SartoriDynamics/Furuta-Pendulum/Furuta 3D printing files/Furuta - TampaCilindro.stl

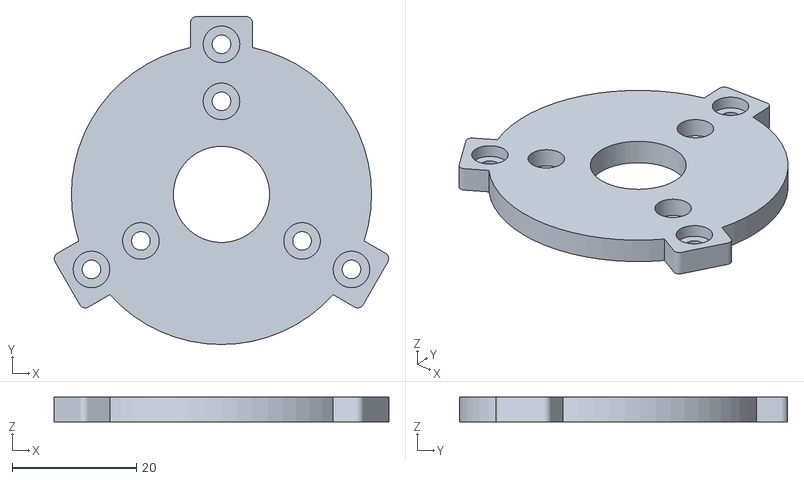
[picture p3: CAD file, 2026-05-11]
Furuta 3D printing files/Furuta - TampaCilindro.stl
53.9 x 52.9 x 4.00
