SartoriDynamics/Furuta-Pendulum/Furuta 3D printing files/Furuta - Haste.stl

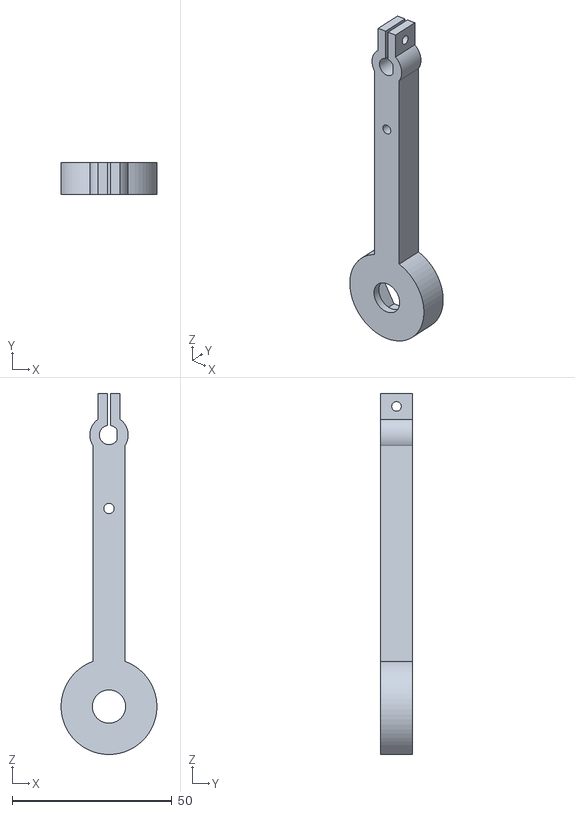
[picture p4: CAD file, 2026-05-11]
Furuta 3D printing files/Furuta - Haste.stl
30.0 x 10.0 x 113.0
