SartoriDynamics/Furuta-Pendulum/Furuta 3D printing files/Furuta - TampaBase.stl

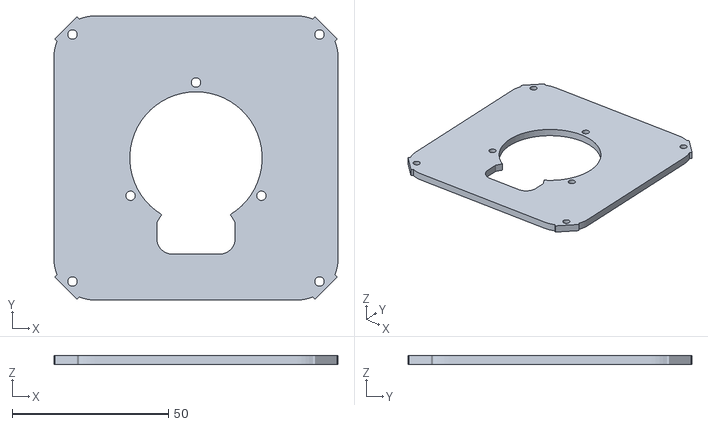
[picture p5: CAD file, 2026-05-11]
Furuta 3D printing files/Furuta - TampaBase.stl
91.0 x 91.0 x 3.00
