SartoriDynamics/Furuta-Pendulum/Furuta 3D printing files/Furuta - Base.stl

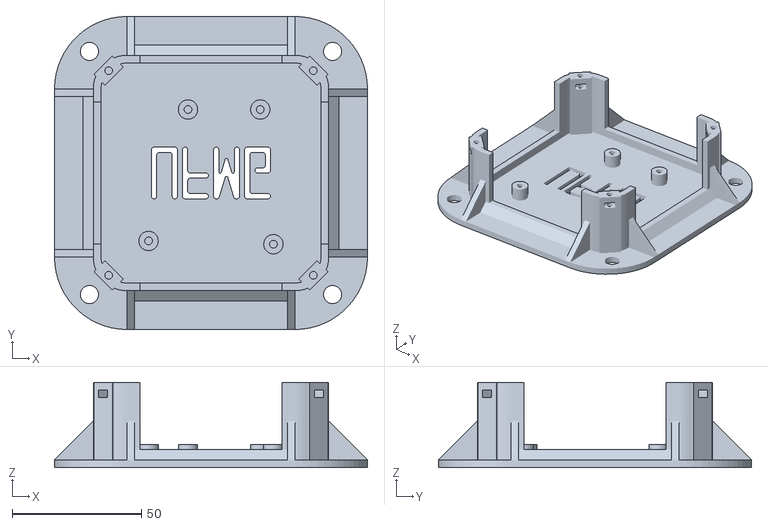
[picture p6: CAD file, 2026-05-11]
Furuta 3D printing files/Furuta - Base.stl
121.0 x 121.0 x 33.0
