SartoriDynamics/Furuta-Pendulum/Furuta 3D printing files/Furuta - BracoRotativo.stl

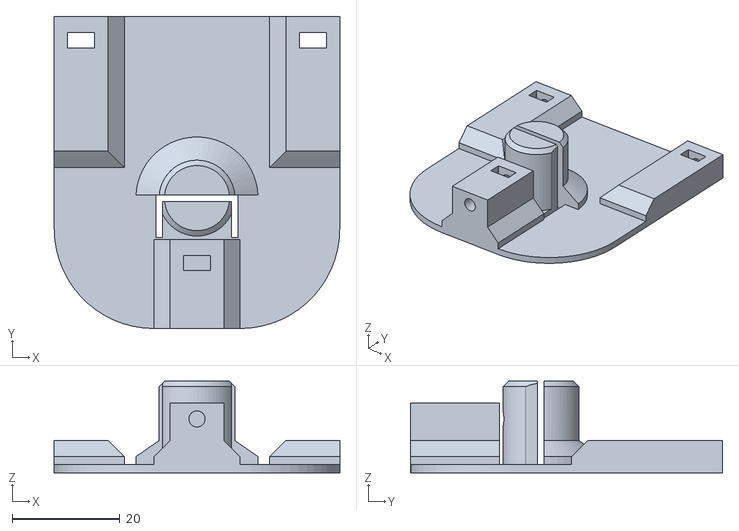
[picture p7: CAD file, 2026-05-11]
Furuta 3D printing files/Furuta - BracoRotativo.stl
53.0 x 57.9 x 17.0
