SartoriDynamics/Furuta-Pendulum/Furuta 3D printing files/Furuta - SuporteEncoder.stl

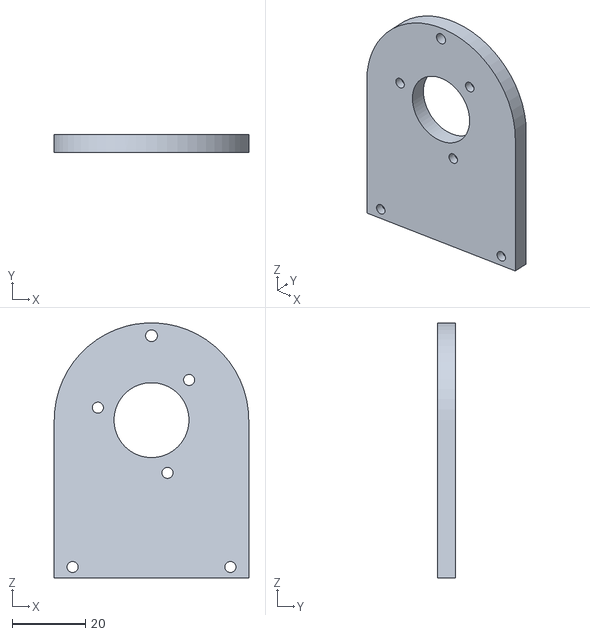
[picture p8: CAD file, 2026-05-11]
Furuta 3D printing files/Furuta - SuporteEncoder.stl
53.0 x 5.00 x 69.5
