SartoriDynamics/Furuta-Pendulum/Furuta 3D printing files/Furuta - Cilindro.stl

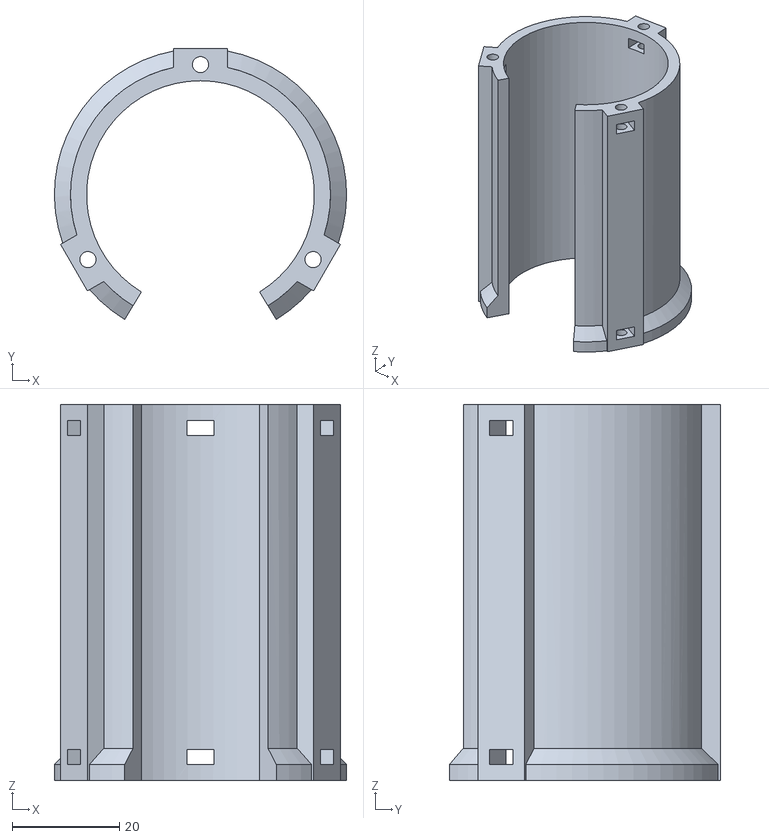
[picture p9: CAD file, 2026-05-11]
Furuta 3D printing files/Furuta - Cilindro.stl
54.4 x 50.5 x 70.0
