SartoriDynamics/Furuta-Pendulum/Python codes/DownwardStepData.txt

2.08 0.000000 0.000000 0.000000 0.000000 0.000000 0.00
2.08 0.000000 0.000000 0.000000 0.000000 0.000000 0.00
2.09 0.000000 0.000000 0.000000 0.000000 0.000000 0.00
2.09 0.000000 0.000000 0.000000 0.000000 0.000000 0.00
2.09 0.000000 0.000000 0.000000 0.000000 0.000000 0.00
2.10 0.000000 0.000000 0.000000 0.000000 0.000000 0.00
2.10 0.000000 0.000000 0.000000 0.000000 0.000000 0.00
2.10 0.000000 0.000000 0.000000 0.000000 0.000000 0.00
2.12 0.000000 0.000000 0.000000 0.000000 0.000000 0.00
2.12 0.000000 0.000000 0.000000 0.000000 0.000000 0.00
2.12 0.000000 0.000000 0.000000 0.000000 0.000000 0.00
2.13 0.000000 0.000000 0.000000 0.000000 0.000000 0.00
2.13 0.000000 0.000000 0.000000 0.000000 0.000000 0.00
2.14 0.000000 0.000000 0.000000 0.000000 0.000000 0.00
2.14 0.000000 0.000000 0.000000 0.000000 0.000000 0.00
2.14 0.000000 0.000000 0.000000 0.000000 0.000000 0.00
2.15 0.000000 0.000000 0.000000 0.000000 0.000000 0.00
2.16 0.000000 0.000000 0.000000 0.000000 0.000000 0.00
2.16 0.000000 0.000000 0.000000 0.000000 0.000000 0.00
2.17 0.000000 0.000000 0.000000 0.000000 0.000000 0.00
2.17 0.000000 0.000000 0.000000 0.000000 0.000000 0.00
2.17 0.000000 0.000000 0.000000 0.000000 0.000000 0.00
2.18 0.000000 0.000000 0.000000 0.000000 0.000000 0.00
2.18 0.000000 0.000000 0.000000 0.000000 0.000000 0.00
2.19 0.000000 0.000000 0.000000 0.000000 0.000000 0.00
2.20 0.000000 0.000000 0.000000 0.000000 0.000000 0.00
2.20 0.000000 0.000000 0.000000 0.000000 0.000000 0.00
2.21 0.000000 0.000000 0.000000 0.000000 0.000000 0.00
2.21 0.000000 0.000000 0.000000 0.000000 0.000000 0.00
2.21 0.000000 0.000000 0.000000 0.000000 0.000000 0.00
2.22 0.000000 0.000000 0.000000 0.000000 0.000000 0.00
2.22 0.000000 0.000000 0.000000 0.000000 0.000000 0.00
2.22 0.000000 0.000000 0.000000 0.000000 0.000000 0.00
2.24 0.000000 0.000000 0.000000 0.000000 0.000000 0.00
2.24 0.000000 0.000000 0.000000 0.000000 0.000000 0.00
2.25 0.000000 0.000000 0.000000 0.000000 0.000000 0.00
2.25 0.000000 0.000000 0.000000 0.000000 0.000000 0.00
2.25 0.000000 0.000000 0.000000 0.000000 0.000000 0.00
2.26 0.000000 0.000000 0.000000 0.000000 0.000000 0.00
2.26 0.000000 0.000000 0.000000 0.000000 0.000000 0.00
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
