SartoriDynamics/Furuta-Pendulum/Python codes/UprightStepData.txt

4.39 0.094126 -0.344985 -0.291586 -0.581114 6.529924 0.00
4.40 0.110186 -0.302272 3.719446 3.382309 1.817587 0.00
4.41 0.128388 -0.240370 2.929203 5.302689 -2.043520 0.00
4.42 0.114113 -0.184680 -1.176501 4.723073 -3.548555 0.00
4.43 0.079749 -0.144243 -4.357677 3.245106 -3.302943 0.00
4.44 0.044803 -0.118012 -5.173871 1.909844 -2.239218 0.00
4.45 0.012548 -0.100870 -4.737822 1.140456 -1.371387 0.00
4.46 -0.004162 -0.084291 -3.154929 1.035681 -1.002472 0.00
4.47 -0.018193 -0.063223 -2.348253 1.382408 -1.565581 0.00
4.48 -0.019045 -0.037417 -1.452251 1.661098 -2.080922 0.00
4.49 -0.018372 -0.011011 -1.306247 1.690366 -2.515808 0.00
4.50 -0.018272 0.003877 -1.482401 0.896615 -1.759669 0.00
4.51 -0.018174 0.016345 -1.190597 0.658768 -1.555241 0.00
4.52 -0.017770 0.021571 -0.989714 0.182934 -0.939711 0.00
4.53 -0.017297 0.025571 -0.653003 0.092846 -0.776166 0.00
4.54 -0.016836 0.029809 -0.483416 0.120040 -0.828286 0.00
4.55 -0.002588 0.030399 0.489285 -0.126426 -0.183168 0.00
4.56 0.000180 0.030336 0.264608 -0.074948 -0.322861 0.00
4.57 0.000198 0.026605 -0.049887 -0.316340 -0.039219 0.00
4.58 -0.000038 0.025829 -0.033328 -0.152140 -0.240940 0.00
4.59 0.013920 0.022105 0.854887 -0.347576 0.380548 0.00
4.60 0.016560 0.017745 0.604399 -0.286432 0.291634 0.00
4.61 0.016554 0.009680 0.309858 -0.517289 0.640453 0.00
4.62 0.030390 0.004545 1.325042 -0.358059 0.851725 0.00
4.63 0.033010 -0.003396 0.935585 -0.407011 0.925167 0.00
4.64 0.032906 -0.012067 0.666071 -0.455061 1.047325 0.00
4.65 0.032646 -0.017070 0.628066 -0.220667 0.804756 0.00
4.66 0.046523 -0.021297 1.476631 -0.172453 1.095238 0.00
4.67 0.048987 -0.021720 1.062138 0.170101 0.509522 0.00
4.68 0.048610 -0.021460 0.490110 0.192700 0.288186 0.00
4.69 0.047886 -0.017691 0.205904 0.363001 -0.096380 0.00
4.70 0.047383 -0.017035 -0.027957 0.136401 0.119739 0.00
4.71 0.047161 -0.017198 0.020567 0.056922 0.244683 0.00
4.72 0.047232 -0.017297 0.109585 0.062995 0.267267 0.00
4.73 0.047340 -0.017297 0.147468 0.077170 0.260671 0.00
4.74 0.047389 -0.017279 0.151255 0.081922 0.255262 0.00
4.75 0.047397 -0.017271 0.147096 0.081732 0.254035 0.00
4.76 0.047393 -0.017270 0.144596 0.080921 0.254297 0.00
4.77 0.047390 -0.017271 0.144072 0.080593 0.254581 0.00
4.78 0.047382 -0.013511 0.143881 0.314668 -0.122327 0.00
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
