SartoriDynamics/Furuta-Pendulum/Python codes/b2Experiment.txt

2.53 0.00000
2.54 0.00000
2.55 0.00000
2.56 0.00000
2.57 0.00000
2.58 0.00000
2.59 0.00000
2.60 0.00000
2.61 0.00000
2.62 0.00000
2.63 0.00000
2.64 0.00000
2.65 0.00000
2.66 0.00000
2.67 0.00000
2.68 0.00000
2.69 0.00000
2.70 0.00000
2.71 0.00000
2.72 0.00000
2.73 0.00000
2.74 0.00000
2.75 0.00000
2.76 0.00000
2.77 0.00000
2.78 0.00000
2.79 0.00000
2.80 0.00000
2.81 0.00000
2.82 0.00000
2.83 0.00000
2.84 0.00000
2.85 0.00000
2.86 0.00000
2.87 0.00000
2.88 0.00000
2.89 0.00000
2.90 0.00000
2.91 0.00000
2.92 0.00000
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
