SartoriDynamics/Furuta-Pendulum/(commit log)

2026-05-09 update repo
    [Arduino IDE Configuration.txt]
2026-05-11 new files
    [Furuta - Base.stl, Furuta - BracoRotativo.stl, Furuta - Cilindro.stl, Furuta - Haste.stl, Furuta - SuporteEncoder.stl, Furuta - TampaBase.stl, Furuta - TampaCilindro.stl]
2026-07-15 Change Furuta Pendulum image width to 100%
    Updated image width for the Furuta Pendulum prototype.
2026-07-15 Modify image width in README
    Adjusted image width for the Furuta Pendulum prototype.
2026-07-15 Update README to improve clarity on data logging
    Clarified how sampled data from the ESP32 can be accessed.
2026-07-15 Change Furuta image from JPG to PNG format
    Updated image source for the Furuta Pendulum prototype.
2026-07-28 Clarify control voltage computation and Python codes
    Updated the README to clarify control voltage computation and streamline the description of Python codes.
2026-07-29 Revise README for clarity and structure
    Updated the README to clarify the Kalman filter and control methods, and reorganized the repository structure for better clarity.
2026-07-29 Update README for clarity on Kalman filter and firmware
    Removed mention of angular velocities in the Kalman filter description and simplified descriptions of LQG firmware.
